LeeMakeKR/Nunchaku-controlled-Mecanum-Omni-Wheel-Robot/pic/502604_1_En_53_Fig1_HTML.png

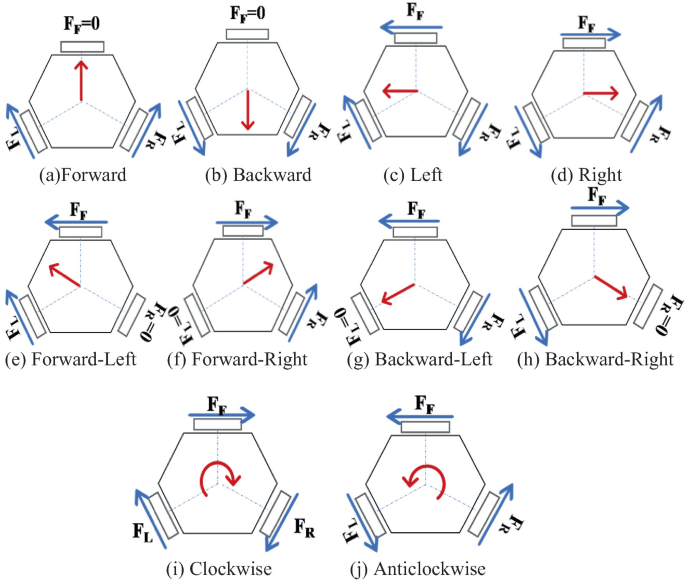
pic/502604_1_En_53_Fig1_HTML.png
