LeeMakeKR/Nunchaku-controlled-Mecanum-Omni-Wheel-Robot/pic/20251120_083218.jpg

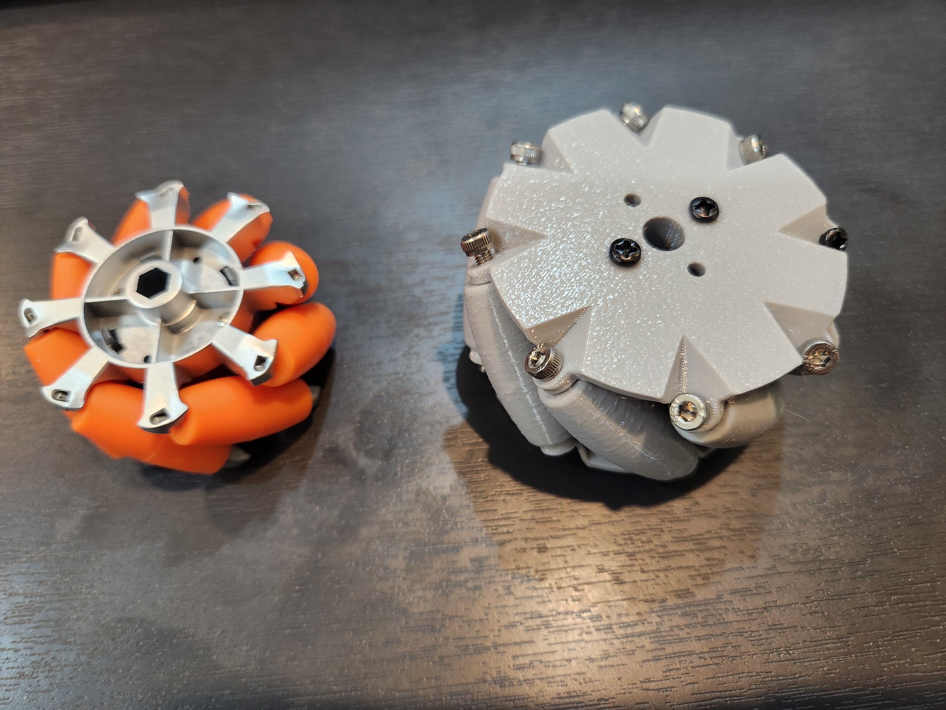
pic/20251120_083218.jpg
