LeeMakeKR/Nunchaku-controlled-Mecanum-Omni-Wheel-Robot/pic/20251123_144223.jpg

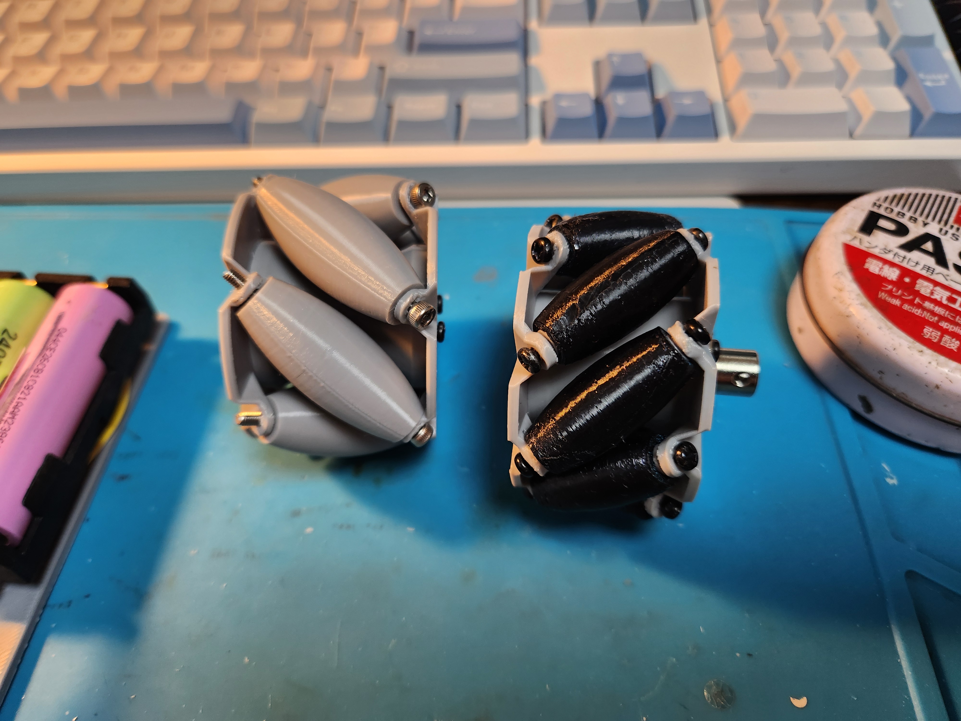
pic/20251123_144223.jpg
