LeeMakeKR/Nunchaku-controlled-Mecanum-Omni-Wheel-Robot/pic/mecanum_image.jpg

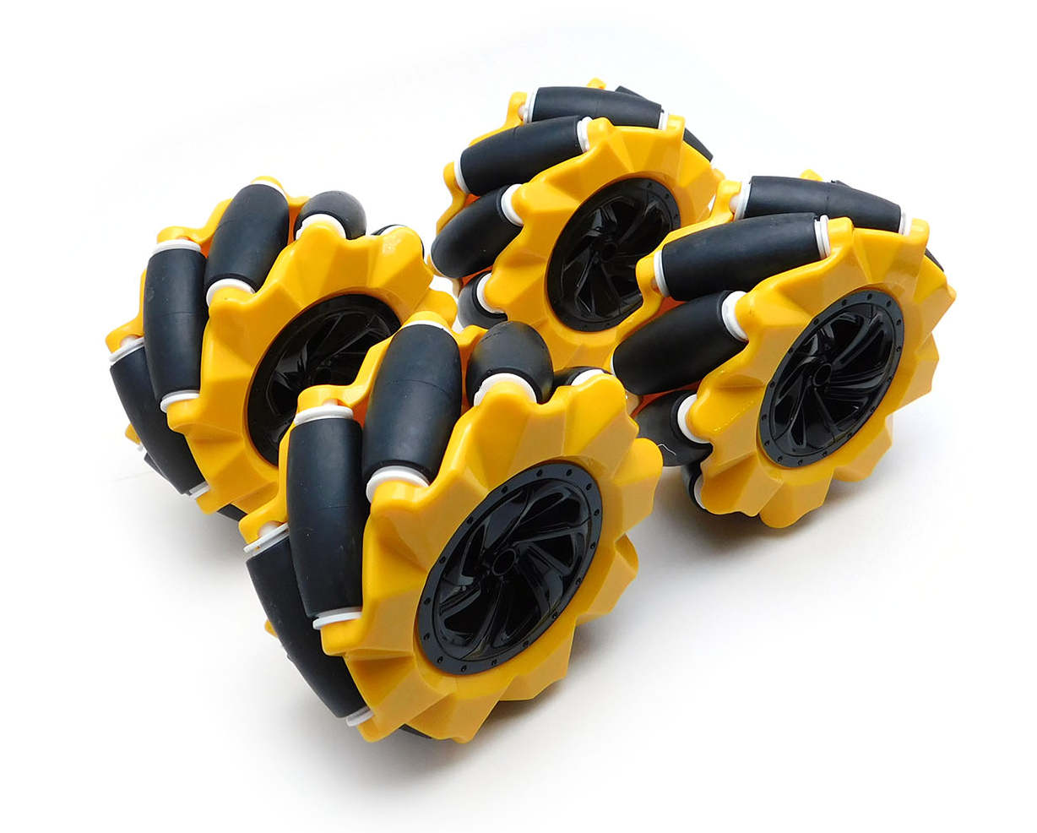
pic/mecanum_image.jpg
