LeeMakeKR/Nunchaku-controlled-Mecanum-Omni-Wheel-Robot/pic/screenshot_2025-12-19 102255.png

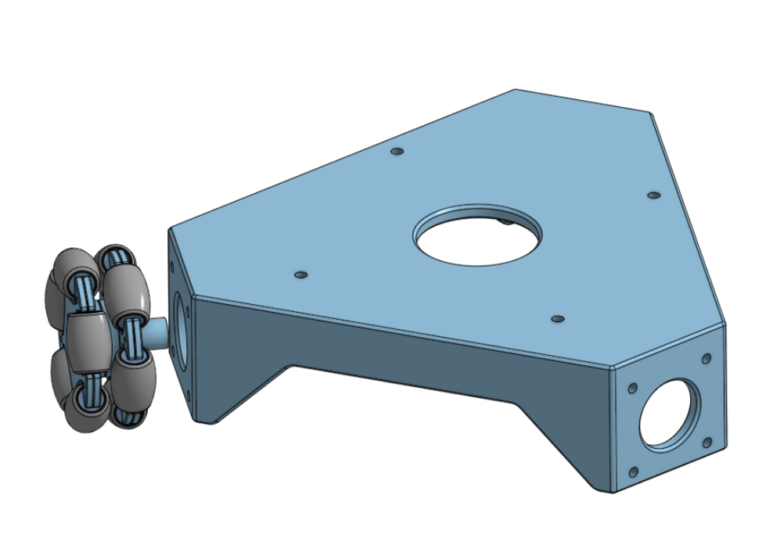
pic/screenshot_2025-12-19 102255.png
