LeeMakeKR/Nunchaku-controlled-Mecanum-Omni-Wheel-Robot/pic/TMC2209_Pinout.jpg

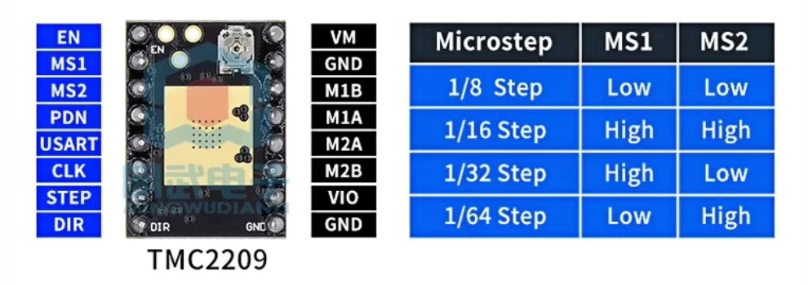
pic/TMC2209_Pinout.jpg
