LeeMakeKR/Nunchaku-controlled-Mecanum-Omni-Wheel-Robot/pic/Wii-Nunchuk-for-Arduino-3-2048.webp

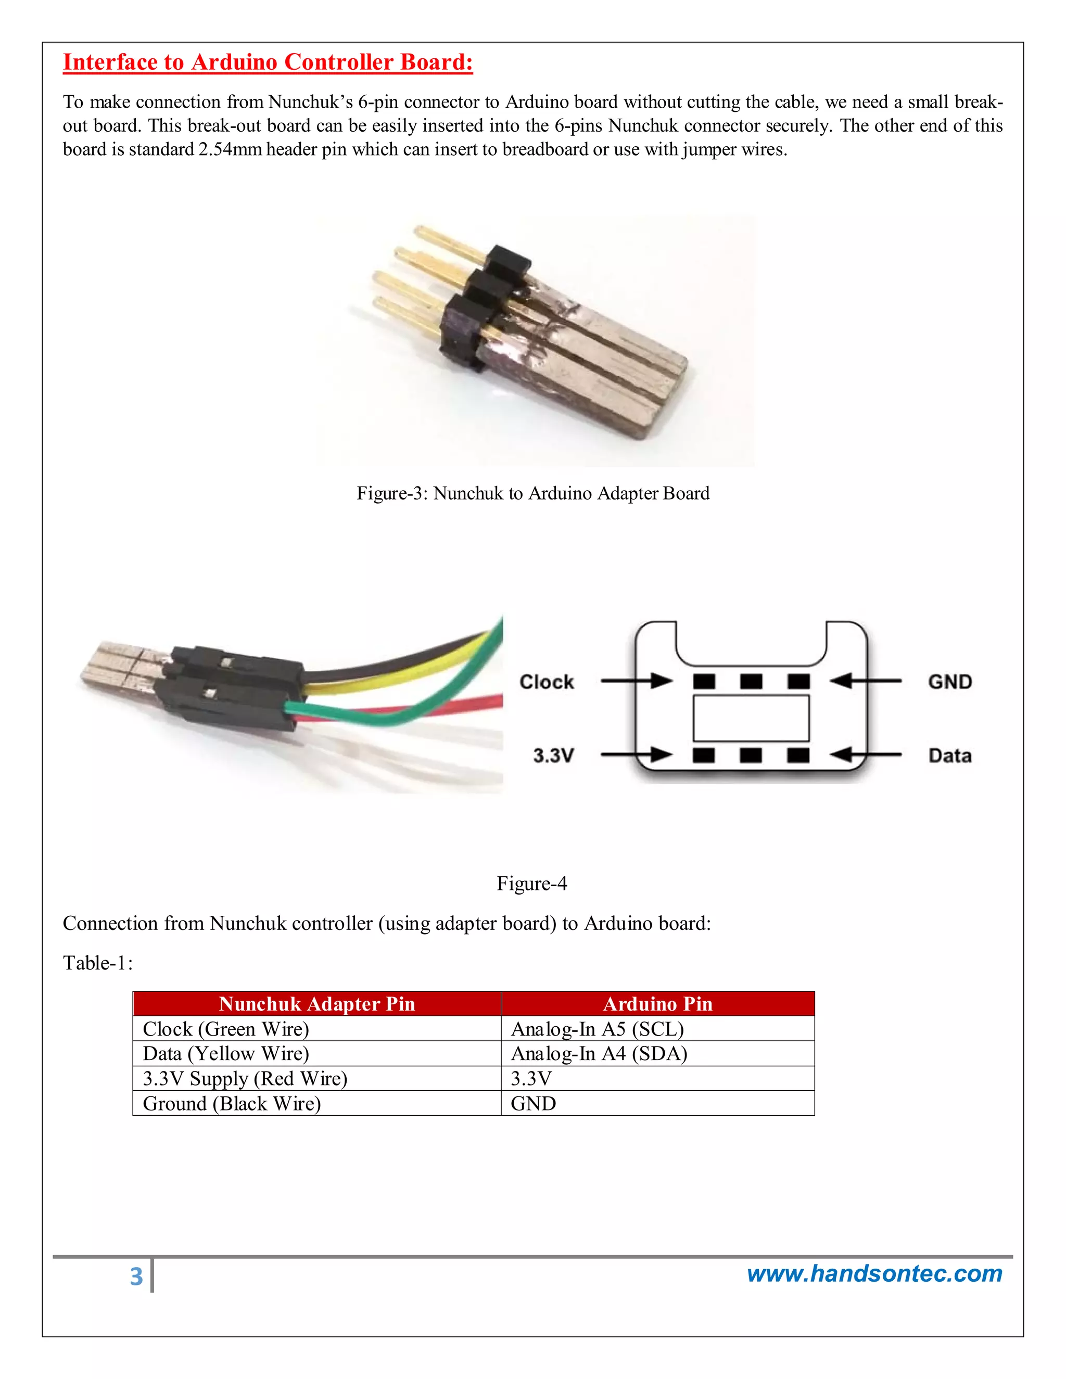
pic/Wii-Nunchuk-for-Arduino-3-2048.webp
