LeeMakeKR/Nunchaku-controlled-Mecanum-Omni-Wheel-Robot/(commit log)

2025-12-17 계산식 추가
2025-12-19 README.md에 이미지 추가 및 관련 수학적 계산 참조 추가, 불필요한 이미지 파일 삭제
2025-12-19 문서 형식 개선 및 내용 가독성 향상
2026-01-01 Enhance Mecanum Wheel control with Nunchaku integration and OLED display support
2026-01-05 메카넘 휠 역기구학 문서에서 트러블슈팅 섹션 삭제
2026-01-05 메카넘 휠 역기구학 문서 업데이트: 전역 좌표계 기반으로 수정 및 내용 보강
2026-01-05 Refactor motor control code for TMC2209 and enhance movement functions for Mecanum wheels
2026-01-06 메카넘 휠 및 옴니휠 제작 섹션 업데이트: 구매 및 출력 제작 옵션 추가
2026-01-19 메카넘 휠 구매 옵션 추가 및 스텝모터 축 지름 확인 안내 문구 추가
2026-01-20 메카넘 휠 제어 코드 및 역기구학 함수의 모터 정의 및 순서를 정리하여 일관성 향상
2026-01-29 좌표계 규칙 및 요 회전 정의 추가, 예시 문구 수정
2026-01-29 Add comprehensive test code for Mecanum Wheel with Wii Nunchaku control
    - Implemented Mecanum Wheel test functionality in Mecanum_Wheel_Test.ino
    - Added support for motor control, joystick calibration, and LED testing.
    - Integrated EEPROM for calibration data storage and retrieval.
    - Enhanced OLED display for user interaction and feedback during tests.
    - Defined motor and joystick parameters for improved control and responsiveness.
2026-01-31 Refactor Mecanum Wheel Test: Update motor pin definitions, enhance joystick menu navigation, and integrate setup mode with EEPROM calibration. Added setup.h for modularity and improved display functi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
2026-01-31 Adjust maximum velocity and acceleration parameters for improved control responsiveness
2026-01-31 Add battery monitoring and OLED display updates for Mecanum robot
2026-02-03 기본 xy 움직임 마무리.
2026-02-04 README.md에 XY 이동 테스트 영상 추가
2026-08-25 Refactor: Remove old TMC2209 step driver test code and add new Omni Wheel control code for 3-wheel Kiwi Drive using Wii Nunchaku
2026-08-25 배터리 모니터링 기능 추가 및 관련 코드 정리
2026-08-25 모터 파라미터 추가: 1회전당 스텝 및 마이크로스텝 설정 정의
